sameerwork826/jyoti-thesis/figures/pcb_3d.png

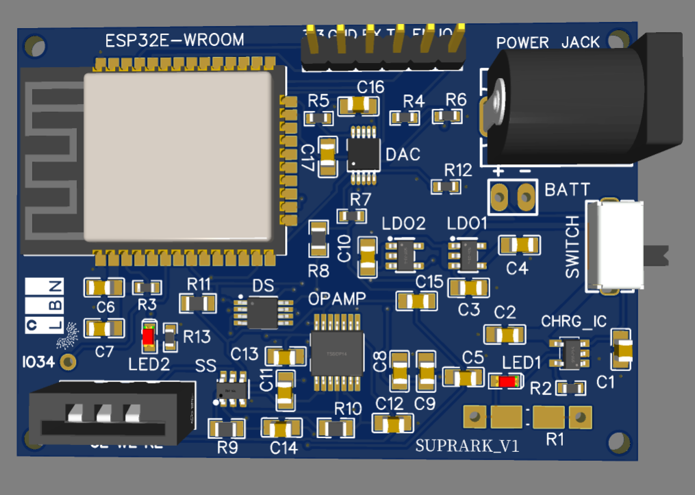
figures/pcb_3d.png
