sameerwork826/jyoti-thesis/README.md

"# jyoti-thesis" 
iit bhu thesis template
https://www.overleaf.com/latex/templates/iit-bhu-varanasi-thesis-template/hhbpqgynrbzv
name - Arkya Jyoti Ghosh
roll no - 21014003
department - Biochemical Engineering
prof name - Dr. Pranjal Chandra
project name - Development of a low cost multimodal amperometric device with web-based monitoring interface for molecular sensing // tentative, subject  to change
