sameerwork826/jyoti-thesis/frontmatter/abbreviations.tex

\chapter*{List of Abbreviations}
\addcontentsline{toc}{chapter}{List of Abbreviations}
\thispagestyle{plain}

\begin{longtable}{@{}p{3.5cm}p{10cm}@{}}
\toprule
\textbf{Abbreviation} & \textbf{Full Form} \\
\midrule
\endhead
\bottomrule
\endfoot

ADC    & Analogue-to-Digital Converter \\
AGND   & Analogue Ground \\
API    & Application Programming Interface \\
BOM    & Bill of Materials \\
CA     & Chronoamperometry \\
CE     & Counter Electrode \\
CV     & Cyclic Voltammetry \\
DAC    & Digital-to-Analogue Converter \\
DET    & Direct Electron Transfer \\
DGND   & Digital Ground \\
DPV    & Differential Pulse Voltammetry \\
EIS    & Electrochemical Impedance Spectroscopy \\
ESP32  & Espressif Systems MCU with integrated Wi-Fi and Bluetooth \\
FDM    & Fused Deposition Modelling \\
FTDI   & Future Technology Devices International (USB-to-UART bridge) \\
HTML   & HyperText Markup Language \\
HTTP   & HyperText Transfer Protocol \\
I$^2$C & Inter-Integrated Circuit (serial communication protocol) \\
IoT    & Internet of Things \\
JSON   & JavaScript Object Notation \\
LDO    & Low-Dropout Regulator \\
LiPo   & Lithium Polymer \\
LOD    & Limit of Detection \\
LOQ    & Limit of Quantification \\
MCU    & Microcontroller Unit \\
MSOP   & Mini Small Outline Package \\
OCP    & Open-Circuit Potential \\
PBS    & Phosphate-Buffered Saline \\
PCB    & Printed Circuit Board \\
PLA    & Polylactic Acid \\
POC    & Point-of-Care \\
RE     & Reference Electrode \\
RSD    & Relative Standard Deviation \\
SoC    & System-on-Chip \\
SPE    & Screen-Printed Electrode \\
SPI    & Serial Peripheral Interface \\
SPIFFS & Serial Peripheral Interface Flash File System \\
TIA    & Transimpedance Amplifier \\
TOF    & Time of Flight \\
UART   & Universal Asynchronous Receiver-Transmitter \\
USB    & Universal Serial Bus \\
WE     & Working Electrode \\
Wi-Fi  & Wireless Fidelity (IEEE 802.11) \\
WS     & WebSocket \\

\end{longtable}
