sameerwork826/jyoti-thesis/frontmatter/certificate.tex

\chapter*{Certificate}
\addcontentsline{toc}{chapter}{Certificate}
\thispagestyle{plain}

\begin{center}
{\large \textbf{INDIAN INSTITUTE OF TECHNOLOGY (BHU), VARANASI}}\\[0.2cm]
{\normalsize School of Biochemical Engineering}\\[1.0cm]
{\Large \textbf{CERTIFICATE}}
\end{center}

\vspace{0.8cm}

This is to certify that the thesis entitled \textbf{``Development of a Low-Cost Multimodal Amperometric Device with Web-Based Monitoring Interface for Molecular Sensing''} submitted by \textbf{Arkya Jyoti Ghosh} (Roll No.\ 21014003) to the Indian Institute of Technology (BHU), Varanasi, is a record of original research work carried out by him under my supervision and guidance in partial fulfillment of the requirements for the award of the degree of \textbf{Bachelor of Technology and Master of Technology (Dual Degree)} in \textbf{Biochemical Engineering}.

\vspace{0.5cm}

To the best of my knowledge, the matter embodied in this thesis has not been submitted to any other university or institute for the award of any degree or diploma.

\vspace{2.5cm}

\noindent
\begin{minipage}[t]{0.45\textwidth}
\textbf{Arkya Jyoti Ghosh}\\
Roll No.\ 21014003\\
B.Tech.--M.Tech.\ (Dual Degree)\\
School of Biochemical Engineering\\
IIT (BHU), Varanasi
\end{minipage}
\hfill
\begin{minipage}[t]{0.45\textwidth}
\textbf{Dr.\ Pranjal Chandra}\\
Professor\\
School of Biochemical Engineering\\
IIT (BHU), Varanasi\\[1.0cm]
Date: \underline{\hspace{4cm}}
\end{minipage}

\vspace{2.0cm}

\noindent
\textbf{Head of Department / Chairman, DPGC}\\
School of Biochemical Engineering\\
IIT (BHU), Varanasi
