sameerwork826/jyoti-thesis/frontmatter/declaration.tex

\chapter*{Declaration}
\addcontentsline{toc}{chapter}{Declaration}
\thispagestyle{plain}

\begin{center}
{\Large \textbf{DECLARATION}}
\end{center}

\vspace{0.8cm}

I, \textbf{Arkya Jyoti Ghosh} (Roll No.\ 21014003), a student of B.Tech.--M.Tech.\ Dual Degree Programme in Biochemical Engineering at the Indian Institute of Technology (BHU), Varanasi, hereby declare that all the information furnished in this thesis, entitled \textbf{``Development of a Low-Cost Multimodal Amperometric Device with Web-Based Monitoring Interface for Molecular Sensing''}, is based on my own research work carried out under the supervision of \textbf{Dr.\ Pranjal Chandra}, Professor, School of Biochemical Engineering, IIT (BHU), Varanasi.

\vspace{0.5cm}

I declare that:
\begin{enumerate}
    \item The thesis comprises only my original research work except where indicated.
    \item Due acknowledgement has been made in the text to all other material used.
    \item The thesis has not been submitted elsewhere for a degree or any other qualification.
\end{enumerate}

\vspace{2.5cm}

\noindent
\begin{minipage}[t]{0.45\textwidth}
Place: Varanasi\\[0.2cm]
Date: \underline{\hspace{4cm}}
\end{minipage}
\hfill
\begin{minipage}[t]{0.45\textwidth}
\textbf{Arkya Jyoti Ghosh}\\
Roll No.\ 21014003\\
B.Tech.--M.Tech.\ Dual Degree\\
School of Biochemical Engineering\\
IIT (BHU), Varanasi
\end{minipage}
