sameerwork826/jyoti-thesis/frontmatter/title.tex

\begin{titlepage}
\begin{center}

\vspace*{0.2cm}

\\[0.45cm]

{\Large \textbf{\institute}}\\[0.2cm]
{\large \textbf{\institutecity}}\\[0.8cm]

{\large \textbf{A Thesis}}\\[0.2cm]
{\normalsize submitted in partial fulfillment of the requirements for the award of the degree of}\\[0.35cm]
{\Large \textbf{\degree}}\\[0.3cm]
{\normalsize in}\\[0.2cm]
{\Large \textbf{\program}}\\[0.75cm]

{\LARGE \textbf{\thetitle}}

\vspace{1.0cm}

{\normalsize Submitted by}\\[0.3cm]
{\Large \textbf{\theauthor}}\\[0.2cm]
{\large Roll No.\ \rollno}

\vspace{0.9cm}

{\normalsize Under the supervision of}\\[0.3cm]
{\Large \textbf{\supervisor}}\\[0.25cm]
{\large \supervisoraffiliation}

\vfill

\textbf{\department}\\
\textbf{\institutewithaddress}\\[0.35cm]
\textbf{\projectstart{} -- \projectend}

\end{center}
\end{titlepage}
