sameerwork826/jyoti-thesis/content/Graphs.pdf

### Thesis Experiments

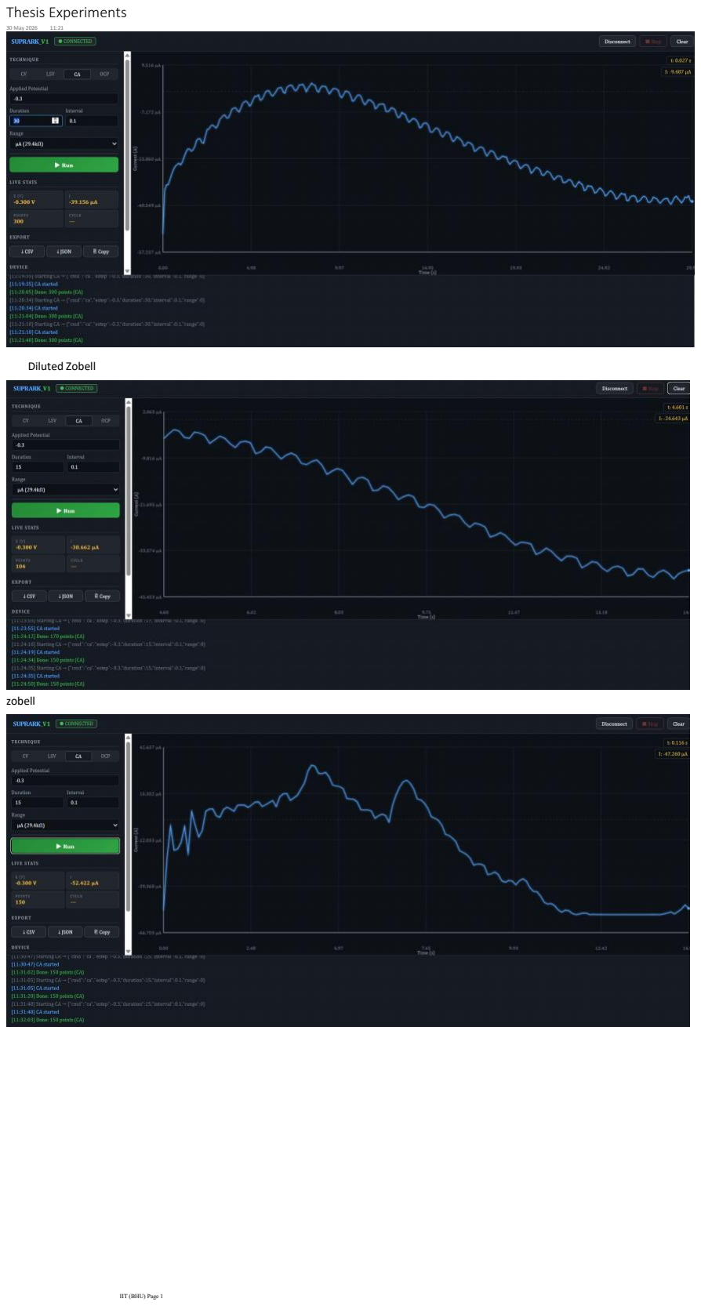
[picture p2: page 1]

Diluted Zobell

zobell

30 May 2026 11:21

IIT (BHU) Page 1

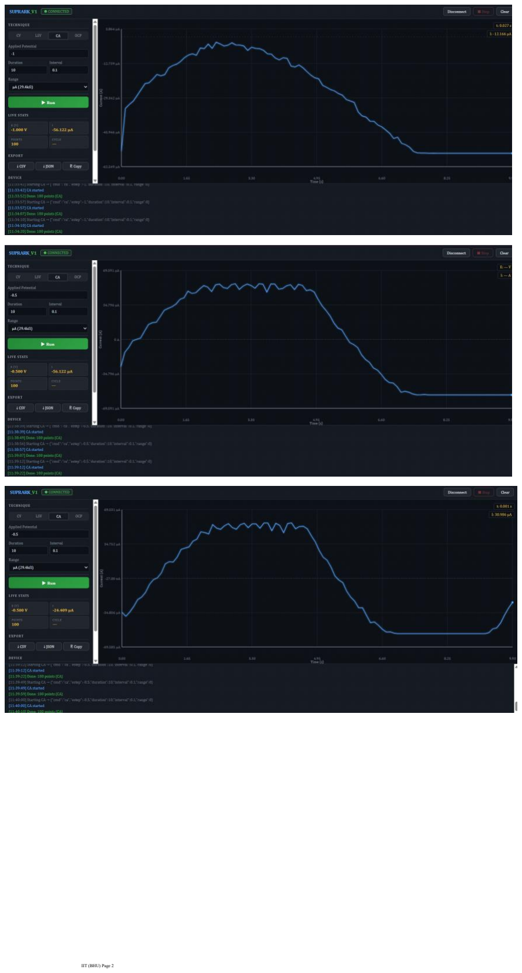
[picture p3: page 2]
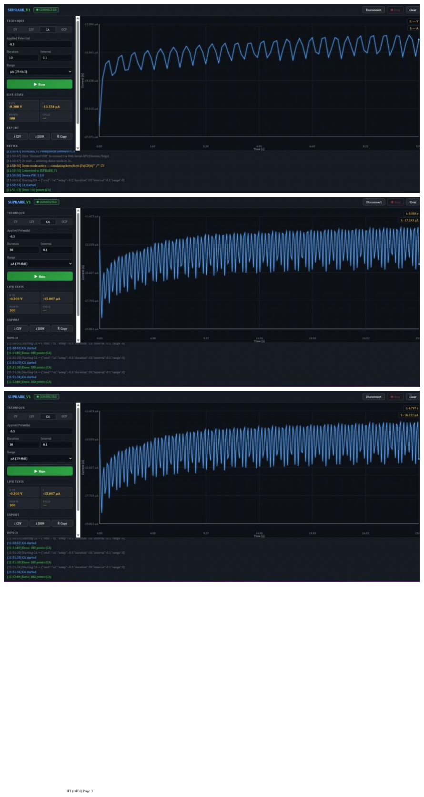
[picture p4: page 3]
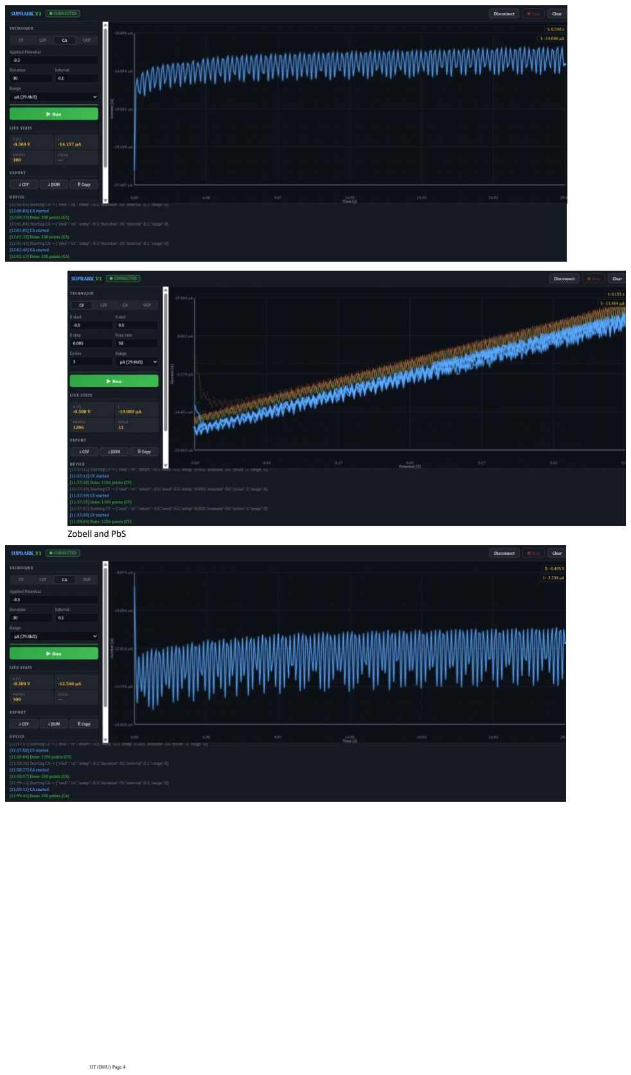
[picture p5: page 4]

Zobell and PbS

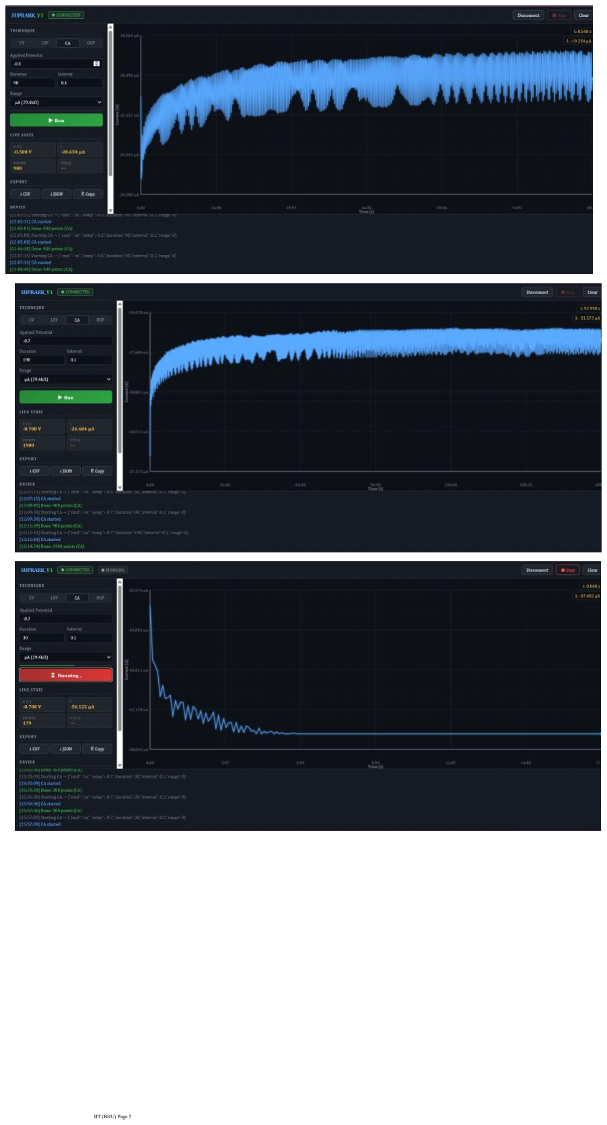
[picture p6: page 5]
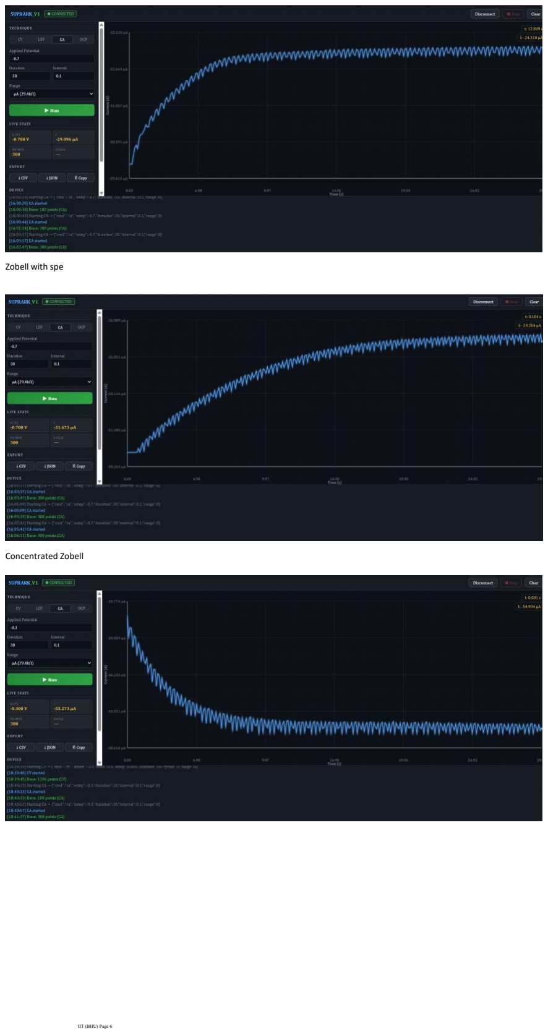
[picture p7: page 6]

Zobell with spe

Concentrated Zobell

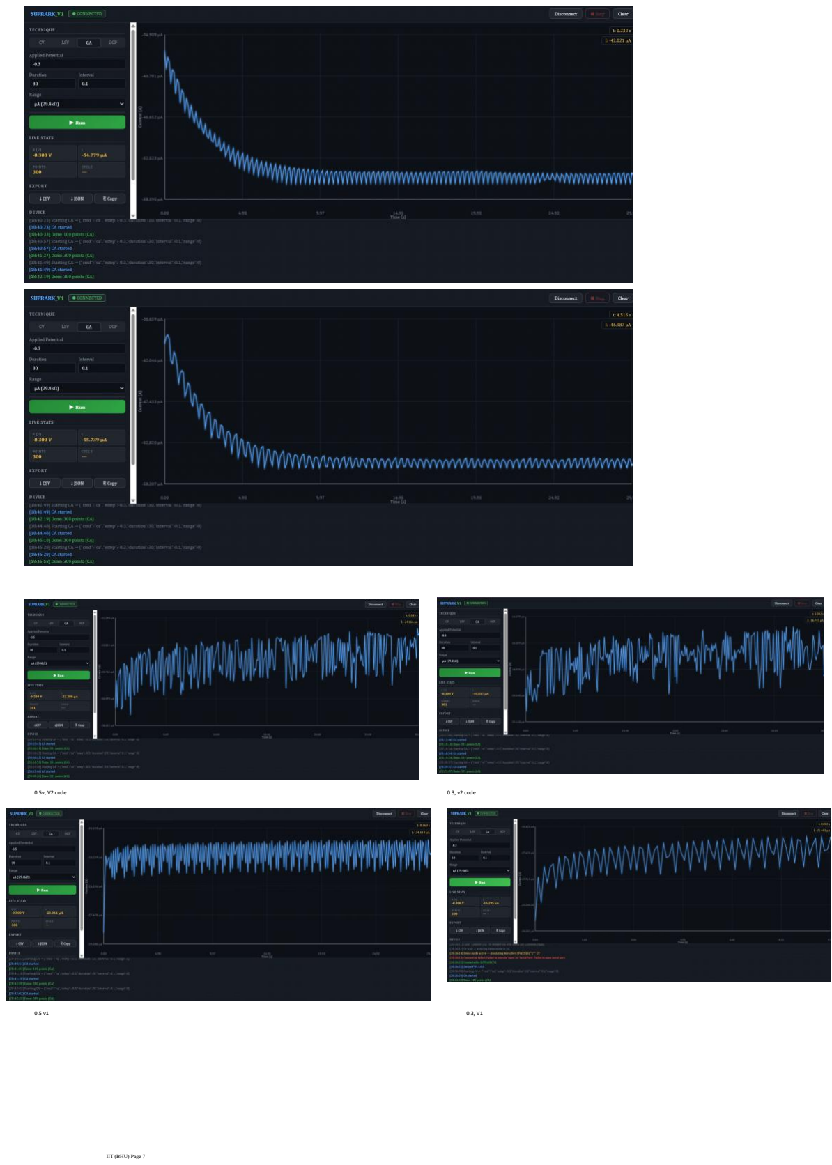
[picture p8: page 7]

0.5v, V2 code | 0.3, v2 code
0.5 v1 | 0.3, V1

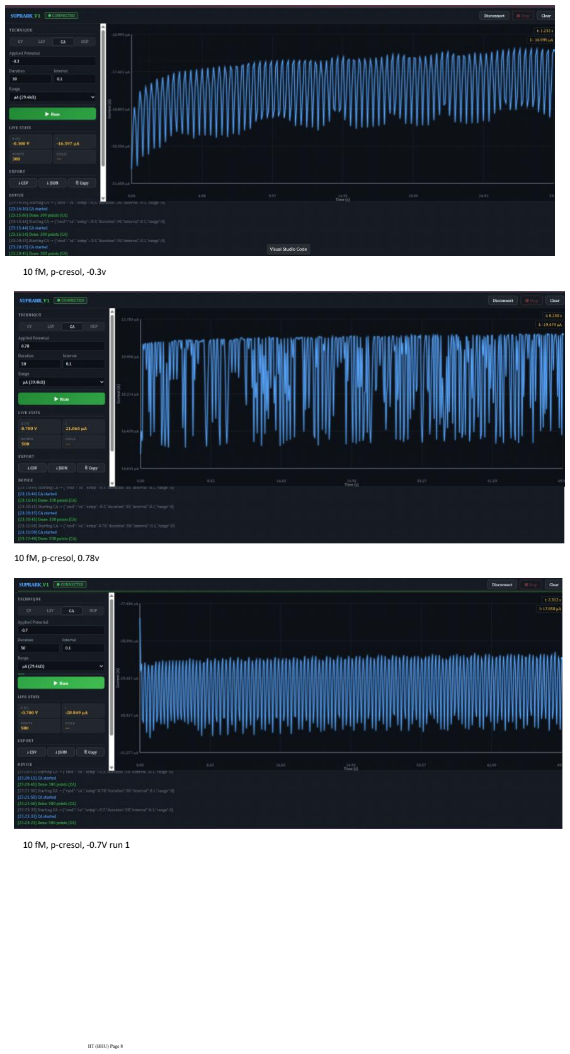
[picture p9: page 8]

10 fM, p-cresol, -0.3v

10 fM, p-cresol, 0.78v

10 fM, p-cresol, -0.7V run 1

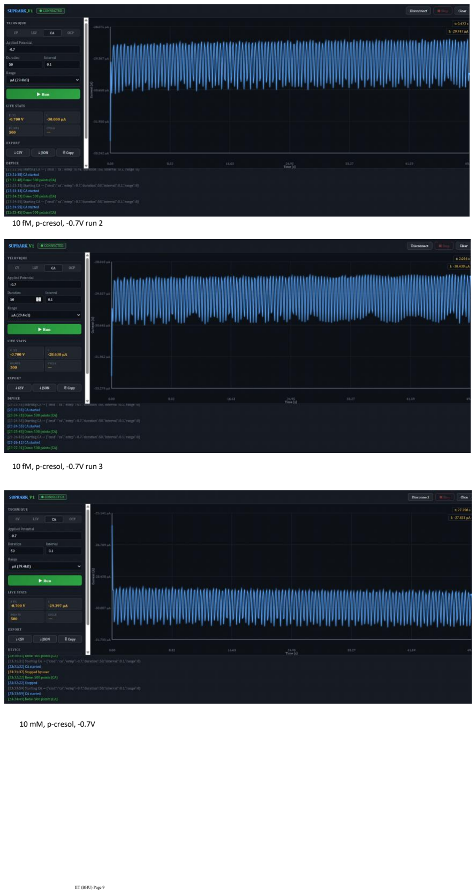
[picture p10: page 9]

10 fM, p-cresol, -0.7V run 2

10 fM, p-cresol, -0.7V run 3

10 mM, p-cresol, -0.7V

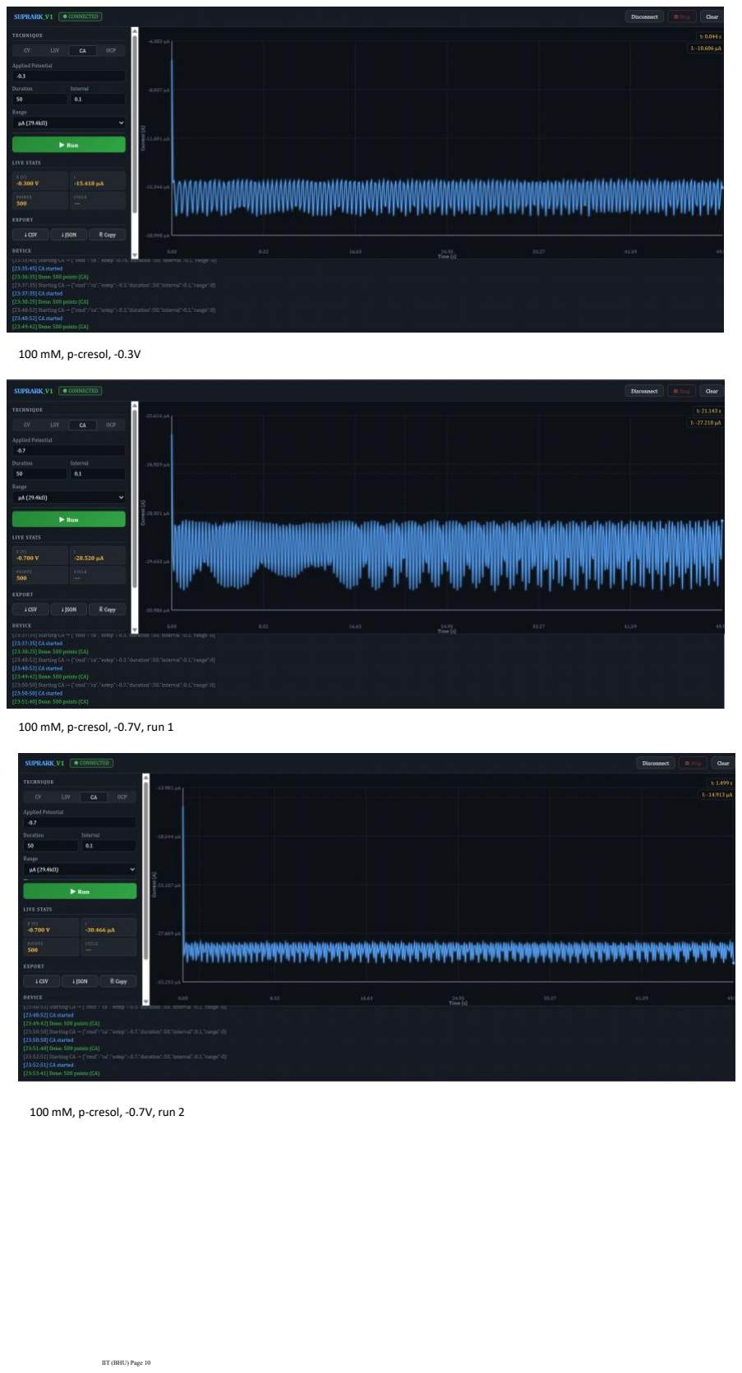
[picture p11: page 10]

100 mM, p-cresol, -0.3V

100 mM, p-cresol, -0.7V, run 1

100 mM, p-cresol, -0.7V, run 2

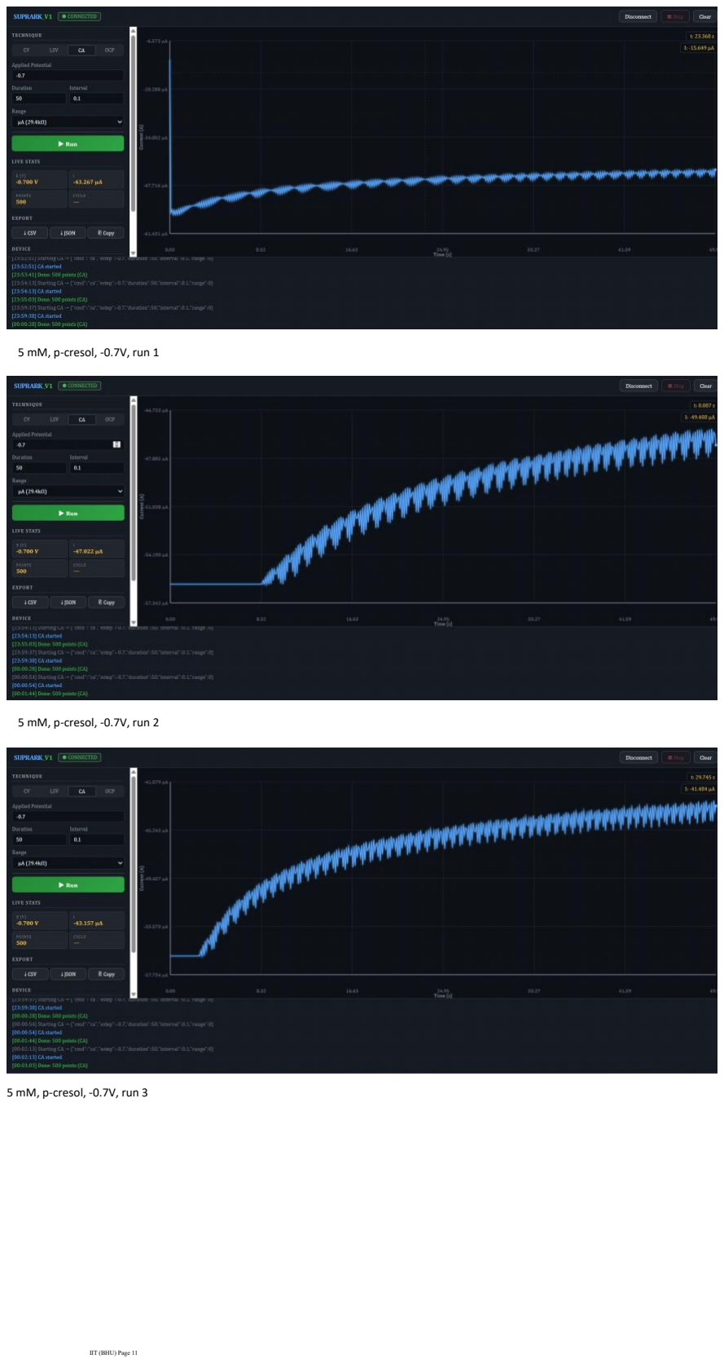
[picture p12: page 11]

5 mM, p-cresol, -0.7V, run 1

5 mM, p-cresol, -0.7V, run 2

5 mM, p-cresol, -0.7V, run 3

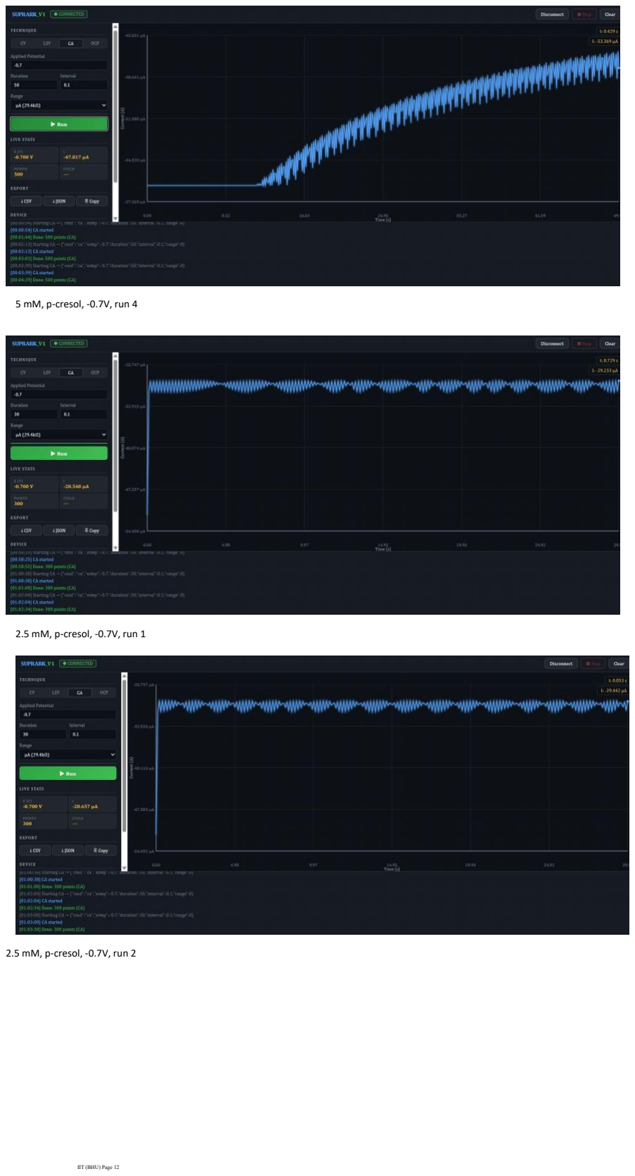
[picture p13: page 12]

5 mM, p-cresol, -0.7V, run 4

2.5 mM, p-cresol, -0.7V, run 1

2.5 mM, p-cresol, -0.7V, run 2

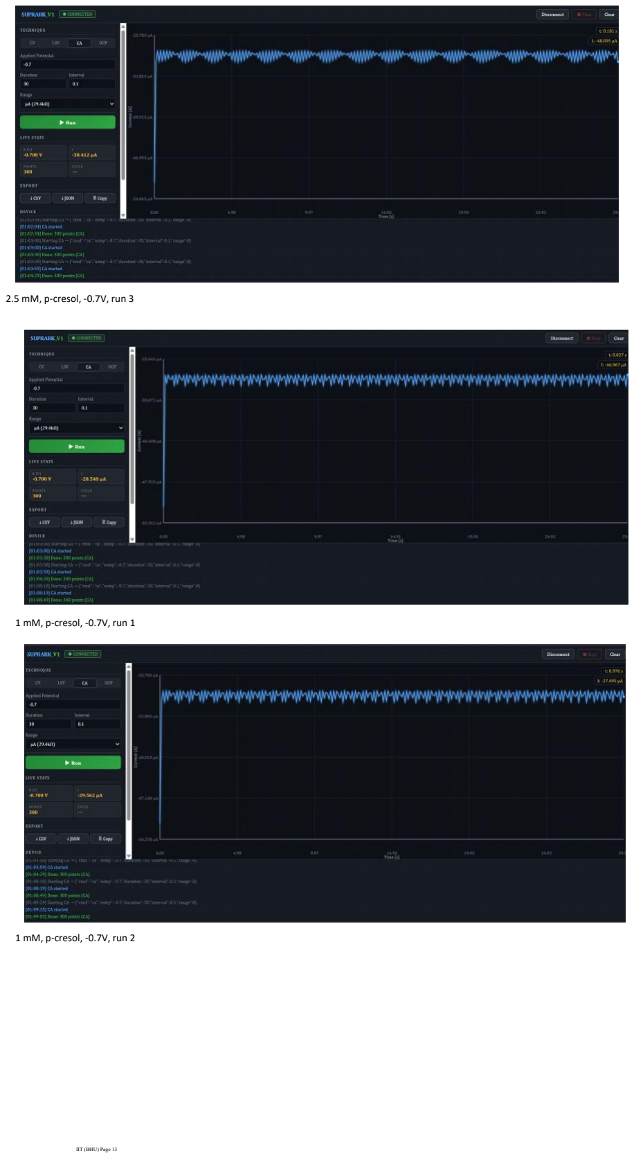
[picture p14: page 13]

2.5 mM, p-cresol, -0.7V, run 3

1 mM, p-cresol, -0.7V, run 1

1 mM, p-cresol, -0.7V, run 2

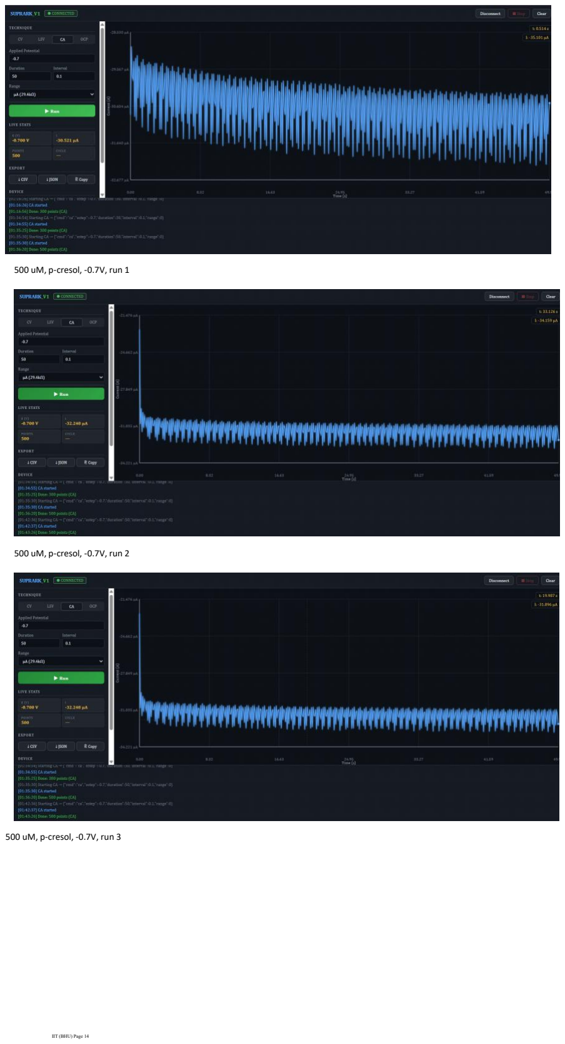
[picture p15: page 14]

500 uM, p-cresol, -0.7V, run 1

500 uM, p-cresol, -0.7V, run 2

500 uM, p-cresol, -0.7V, run 3

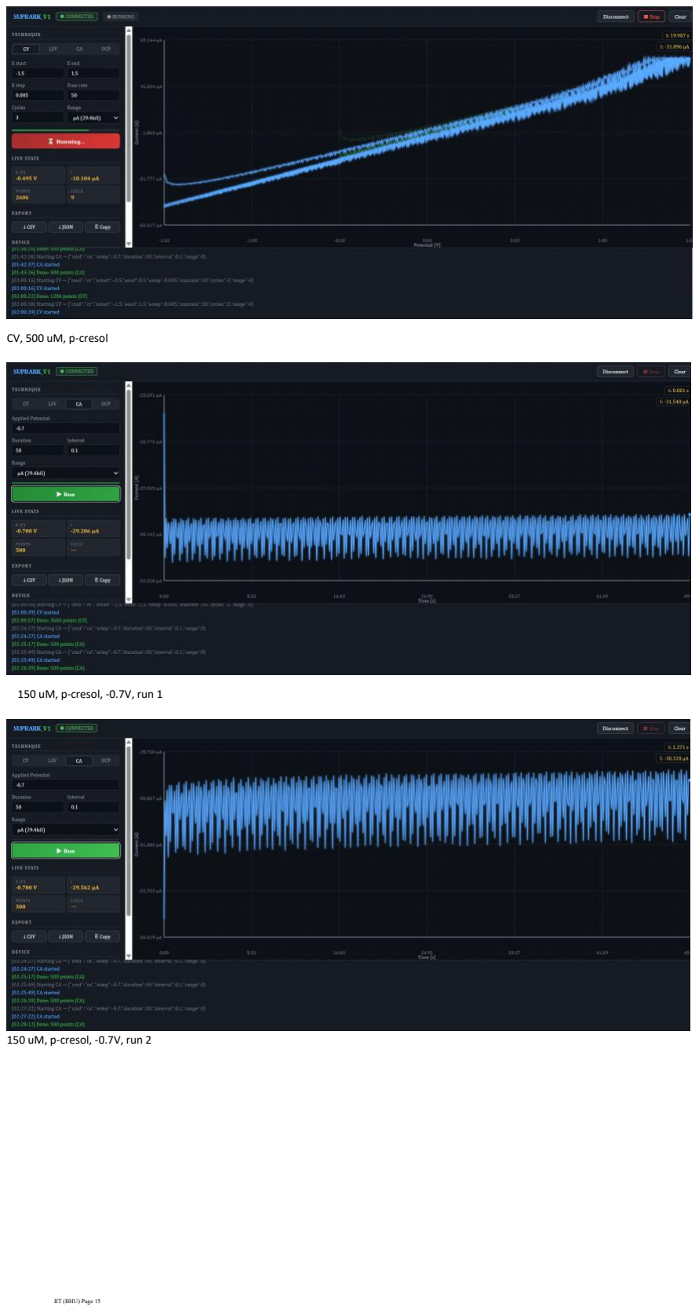
[picture p16: page 15]

CV, 500 uM, p-cresol

150 uM, p-cresol, -0.7V, run 1

150 uM, p-cresol, -0.7V, run 2

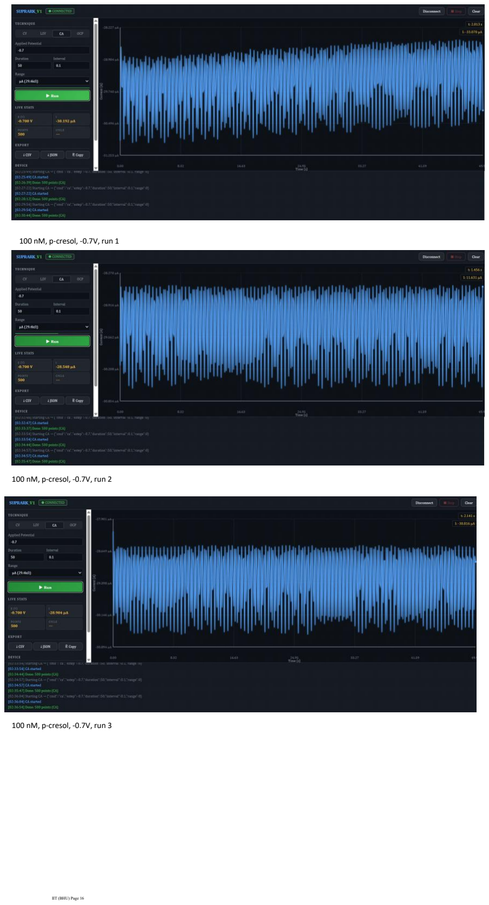
[picture p17: page 16]

100 nM, p-cresol, -0.7V, run 1

100 nM, p-cresol, -0.7V, run 2

100 nM, p-cresol, -0.7V, run 3

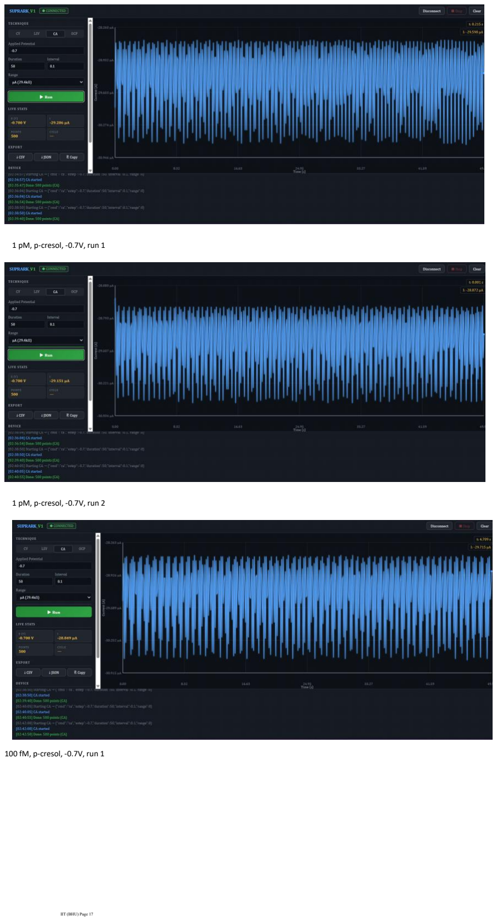
[picture p18: page 17]

1 pM, p-cresol, -0.7V, run 1

1 pM, p-cresol, -0.7V, run 2

100 fM, p-cresol, -0.7V, run 1

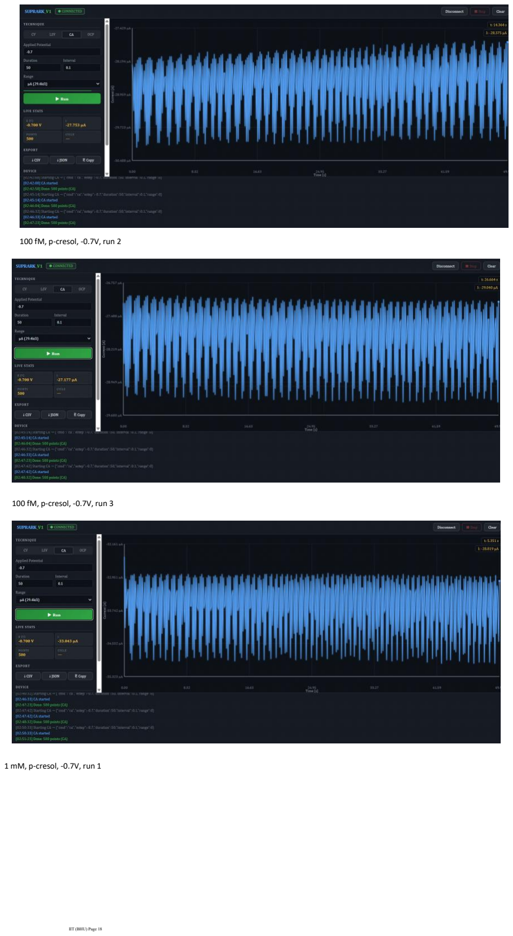
[picture p19: page 18]

100 fM, p-cresol, -0.7V, run 2

100 fM, p-cresol, -0.7V, run 3

1 mM, p-cresol, -0.7V, run 1

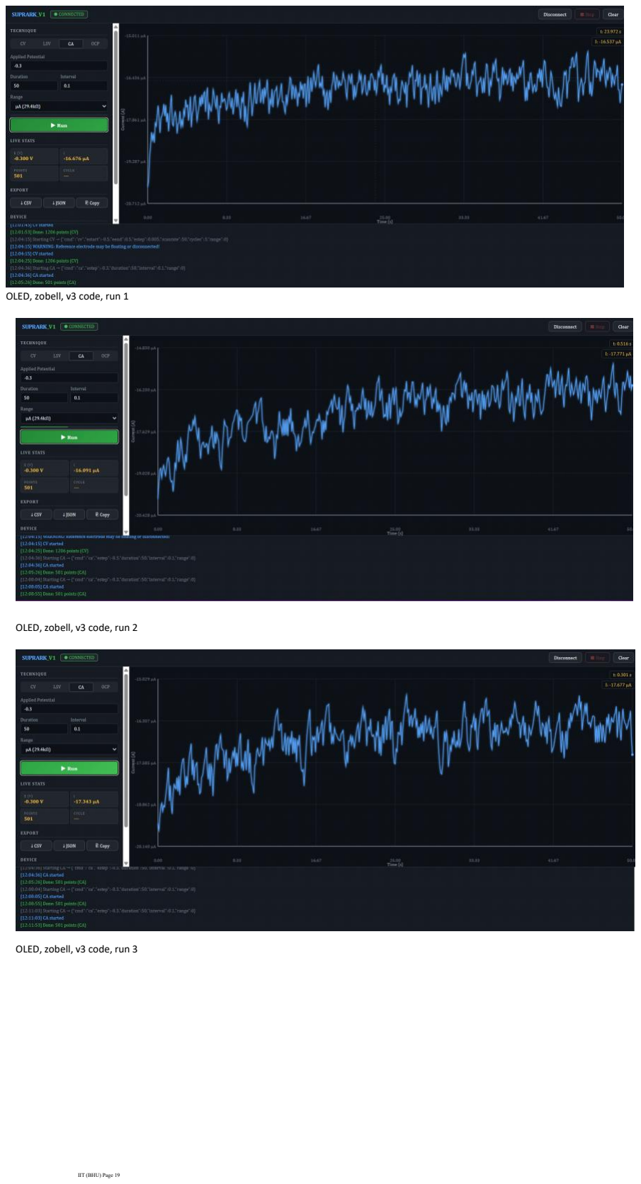
[picture p20: page 19]

OLED, zobell, v3 code, run 1

OLED, zobell, v3 code, run 2

OLED, zobell, v3 code, run 3

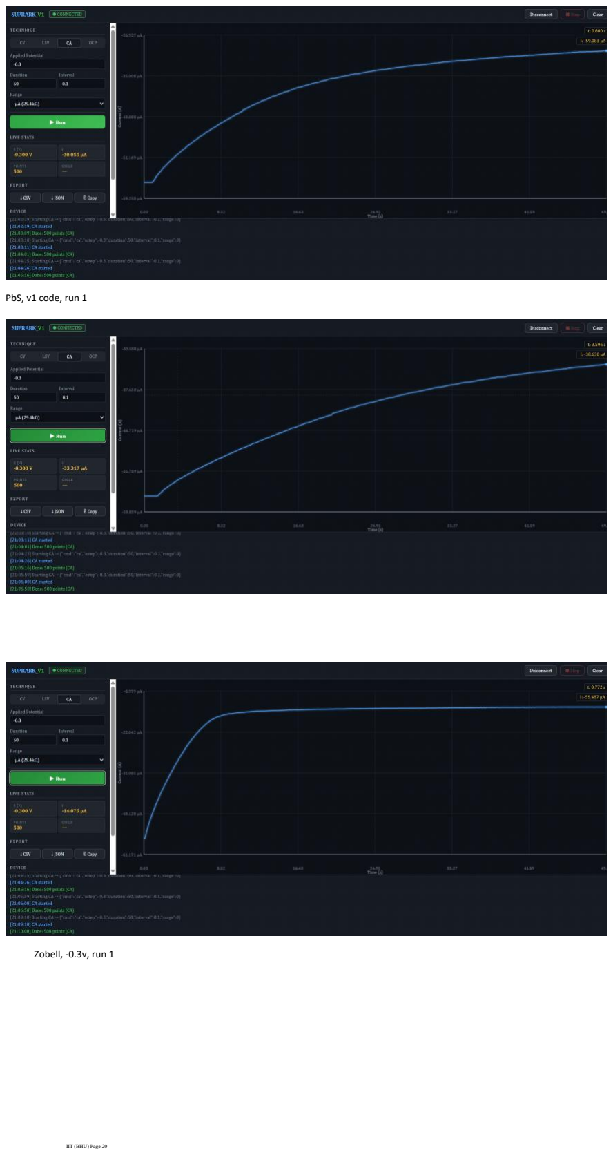
[picture p21: page 20]

PbS, v1 code, run 1

Zobell, -0.3v, run 1

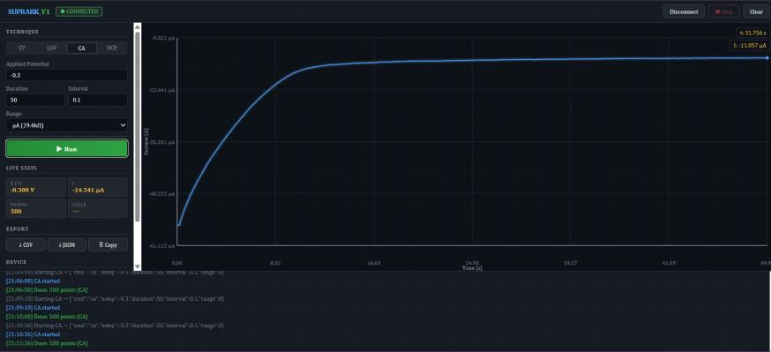
[picture p22: figure]

Zobell, -0.3v, run 1, stabilizng at exactly same voltage, craxxxyyyyyy
