sameerwork826/jyoti-thesis/content/Patent.md

Please fill out this IITBHU patent application form for me, copy the same format as in the docx file, and instead of the thermal imaging system, this patent is for the amperometric device that we have developed for molecular sensing.You can use the same title or think of something new, now that you know what we have used it for and how, what it is etc. So fill all the sections accordingly, keep the names of the inventors and everythig the same, use today's dates, fill it up nicely.

follow these instruction and fill new patent intial draft docx for me
