sameerwork826/jyoti-thesis/frontmatter/acknowledgements.tex

\chapter*{Acknowledgements}
\addcontentsline{toc}{chapter}{Acknowledgements}
\thispagestyle{plain}

I would like to express my sincere gratitude to all those who have contributed to the successful completion of this thesis.

First and foremost, I am deeply indebted to my thesis supervisor, \textbf{Dr.\ Pranjal Chandra}, Professor, School of Biochemical Engineering, IIT (BHU), Varanasi, for his invaluable guidance, constant encouragement, and intellectual support throughout the course of this research. His vision for innovative biosensing and his insistence on rigorous scientific methodology have profoundly shaped this work. I am grateful for his patience in allowing me to explore the intersection of hardware engineering and biochemistry, and for providing the freedom to prototype and iterate rapidly.

I am thankful to the \textbf{School of Biochemical Engineering, IIT (BHU), Varanasi}, and its faculty members for providing the necessary academic and laboratory facilities. I also thank the \textbf{Head of the Department} and the \textbf{Chairman, DPGC}, for their administrative support.

I owe special thanks to my fellow lab members for their support, stimulating discussions, and assistance during the experimental phases of this project. Their camaraderie made long hours in the laboratory enjoyable and productive.

I extend my appreciation to \textbf{JLCPCB} for prompt and high-quality PCB fabrication, and to the open-source communities behind the ESP32 Arduino ecosystem, EasyEDA, PlatformIO, and the various libraries employed in the firmware and web application.

I am profoundly grateful to my \textbf{parents and family} for their unconditional love, constant encouragement, and unwavering faith in me throughout my academic journey. Without their support, this work would not have been possible.

Finally, I acknowledge the financial support provided by \textbf{IIT (BHU), Varanasi} through its research and academic facilities.

\vspace{1.5cm}
\noindent\hfill \textbf{Arkya Jyoti Ghosh}\\
\hfill Varanasi, 2026
