sameerwork826/jyoti-thesis/content/BOM_Potentiostat-Project_2025-10-22.csv

ID | Name | Designator | Footprint | Quantity | Manufacturer Part | Manufacturer | Supplier | Supplier Part | Price
1 | MIC5205-3.3YM5 | 3.3V_LDO_1,3.3V_LDO_2 | SOT-23-5_L3.0-W1.7-P0.95-LS2.8-TL | 2 | MIC5205-3.3YM5-TR | MICROCHIP(美国微芯) | LCSC | C37970 | 0.365
2 | Batt | BT1 | BAT-TH_2P-9VBATTERY | 1 | 9V电池铜线扣 铜100mm | Q&J | LCSC | C70374 | 0.103
3 | 4.7uF | C1,C2 | C0805 | 2 | TCC0805X5R475M500FT | CCTC(三环) | LCSC | C7393930 | 0.016
4 | 10uF | C3,C6,C9,C10,C17 | C0805 | 5 | GRT21BC71E106KE13L | muRata(村田) | LCSC | C882505 | 0.115
5 | 470pF | C4,C5 | C0805 | 2 | GCM21A7U2E471JX01D | muRata(村田) | LCSC | C417152 | 0.06
6 | 100nF | C7,C8,C11,C14,C15,C16 | C0805 | 6 | CC0805JRX7R7BB104 | YAGEO(国巨) | LCSC | C520082 | 0.008
7 | 10nF | C12,C13 | C0805 | 2 | CGA0805X7R103K101KT | HRE(芯声) | LCSC | C7503490 | 0.005
8 | AD5667RBRMZ-2REEL7 | DAC | MSOP-10_L3.0-W3.0-P0.50-LS4.9-BL | 1 | AD5667RBRMZ-2REEL7 | ADI(亚德诺) | LCSC | C650006 | 15.353
9 | MAX4643EUA+ | DUAL_SWITCH | UMAX-8_L3.0-W3.0-P0.65-LS4.9-BL | 1 | MAX4643EUA+ | ADI(亚德诺)/MAXIM(美信) | LCSC | C1546042 | 4.384
10 | HDR-M-2.54_1x1 | J1,J2,J3,J4,J5,J6 | HDR-M-2.54_1X1 | 6 |  |  | LCSC | C81276 | 0.007
11 | LED-0603_R | LED1,LED2 | LED0603_RED | 2 | 19-217/R6C-AL1M2VY/3T | EVERLIGHT(台湾亿光) | LCSC | C72044 | 0.021
12 | 470E | R1 | RESISTOR_SMD+THTUNIVERSAL_0805TO1206_RM10_HANDSOLDERING_REVA_DATE25JUN2010 | 1 | RN1WS470ΩFT/BA1 | Tyohm(幸亚电阻) | LCSC | C385392 | 0.02
13 | 2K | R2 | R0603 | 1 | RMS06JT202 | 大毅科技 | LCSC | C209226 | 0.003
14 | 10k | R3,R4,R5,R6,R12 | R0603 | 5 | TC0325D1002T5F | UNI-ROYAL(厚声) | LCSC | C2989345 | 0.01
15 | 1.2k | R7 | R0603 | 1 | ARG03BTC1201 | Viking(光颉) | LCSC | C2984430 | 0.023
16 | 16.2k | R8 | R0805 | 1 | AC0805FR-0716K2L | YAGEO(国巨) | LCSC | C228332 | 0.005
17 | 845 | R9 | R0805 | 1 | ARG05FTC8450N | Viking(光颉) | LCSC | C218710 | 0.008
18 | 29.4k | R10 | R0805 | 1 | AC0805FR-0729K4L | YAGEO(国巨) | LCSC | C228690 | 0.004
19 | 8.06k | R11 | R0805 | 1 | 0805W8F8061T5E | UNI-ROYAL(厚声) | LCSC | C19006 | 0.002
20 | 220 | R13 | R0603 | 1 | AC0603FR-07220RL | YAGEO(国巨) | LCSC | C138284 | 0.002
21 | TPMAX4644EUT+T | SINGLE_SWITCH | SOT-23-6_L2.9-W1.6-P0.95-LS2.9-BL | 1 | TPMAX4644EUT+T | TECH PUBLIC(台舟) | LCSC | C42449032 | 0.335
22 | DS1020-03ST1D_C40878053 | SPE_CONNECTOR | CONN-TH_3P-P2.54_DS1020-03ST1D | 1 | DS1020-03ST1D | null | LCSC | C40878053
23 | SK-12D02-VG5 | SW1 | SW-TH_SK-12D02VG3 | 1 | SK-12D02-VG5 | Rectangular Connectors - Contacts | LCSC | C136722 | 0.074
24 | POWER-JACK | U1 | DC-IN-TH_POWER-JACK | 1 | POWER-JACK | 索峰 | LCSC | C9900001795
25 | MCP73831T-2ATI/OT | U3 | SOT-23-5_L3.0-W1.7-P0.95-LS2.8-BR | 1 | MCP73831T-2ATI/OT | MICROCHIP(美国微芯) | LCSC | C14879 | 1.701
26 | ESP32-WROOM-32E(4MB) | U6 | WIFI-SMD_ESP32-WROOM-32E | 1 | ESP32-WROOM-32E-N4 | ESPRESSIF(乐鑫) | LCSC | C701341 | 3.85
27 | AD8608ARUZ | U11 | TSSOP-14_L5.0-W4.4-P0.65-LS6.4-BL | 1 | AD8608ARUZ | ADI(亚德诺) | LCSC | C578776 | 4.17
