sameerwork826/jyoti-thesis/content/Bottom.stl

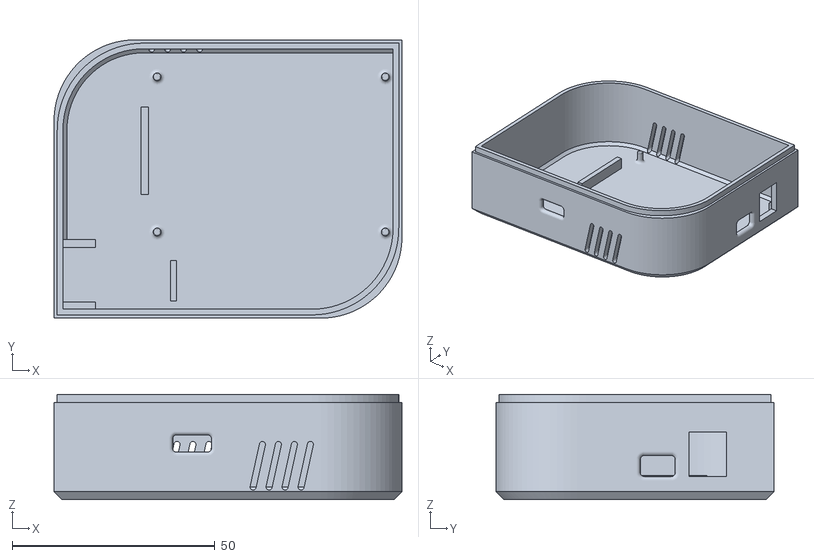
[picture p23: CAD file, 2026-06-01]
content/Bottom.stl
85.8 x 68.6 x 26.0
