sameerwork826/jyoti-thesis/content/Top.stl

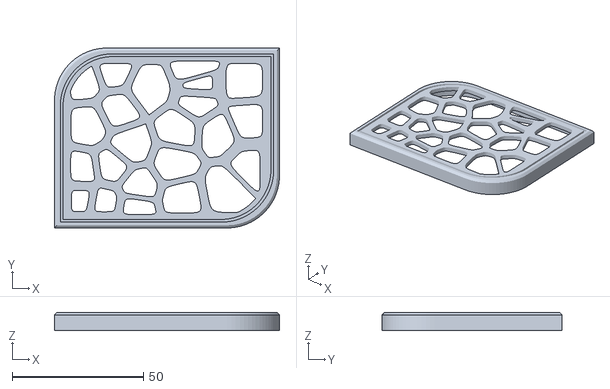
[picture p24: CAD file, 2026-06-01]
content/Top.stl
85.8 x 68.6 x 7.00
