sameerwork826/jyoti-thesis/content/Schematic_Potentiostat-Project_2026-05-29.pdf

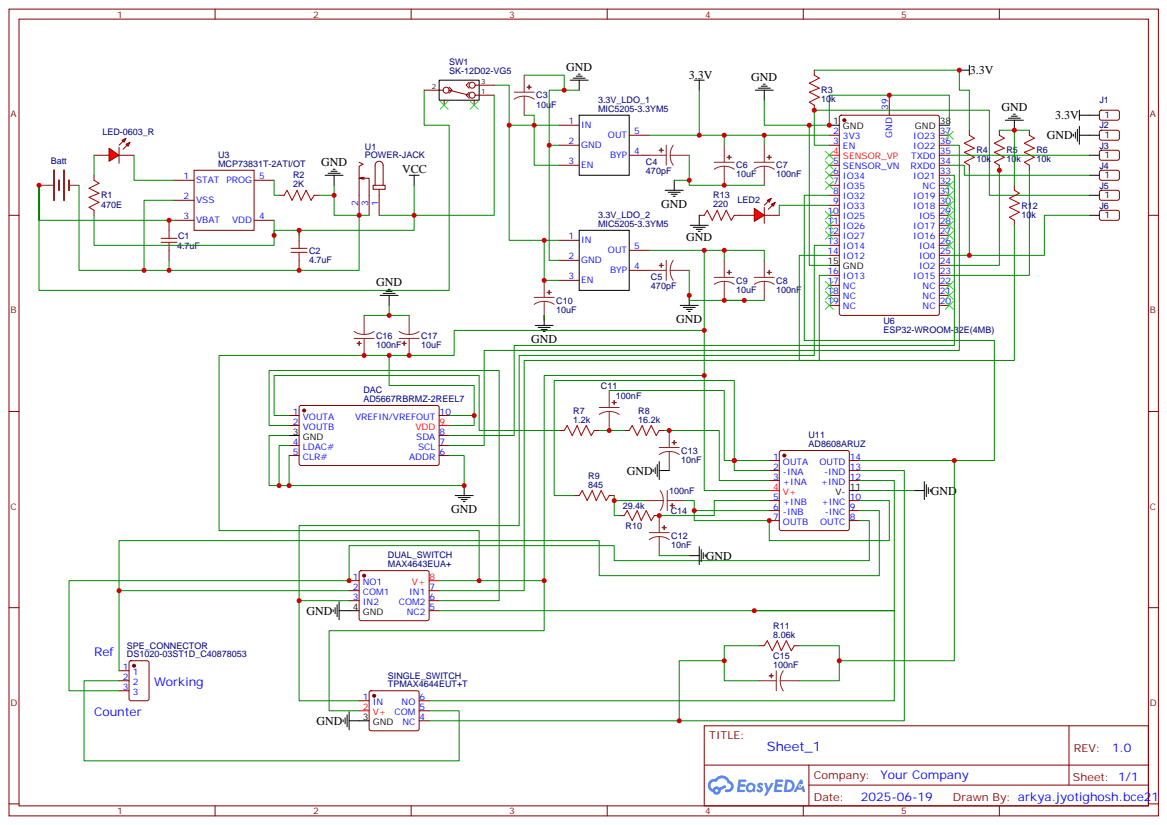
[picture p25: page 1]

Drawn By: arkya.jyotighosh.bce21
