sameerwork826/jyoti-thesis/(commit log)

2026-06-01 feat: complete IIT BHU dual degree thesis scaffold in LaTeX
    - main.tex + preamble.tex with IIT BHU formatting (Times font, 1.5 spacing, binding margins)
    - frontmatter: title page, certificate, declaration, abstract, acknowledgements, abbreviations
    - Chapter 1: Introduction (background, analytes, objectives, scope)
    - Chapter 2: Literature Review (CA theory, open-source potentiostats, p-cresol, H2O2, redox probes)
    - Chapter 3: Materials and Methods (hardware, firmware, web UI, 3D enclosure, protocols)
    - Chapter 4: Results and Discussion (device validation, Cottrell analysis, calibration curves, cost)
    - Chapter 5: Conclusion and Future Work
    - Appendix A: Full BOM table and PCB specifications
    -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
    [BOM_Potentiostat-Project_2025-10-22.csv, Bottom.stl, Top.stl]
2026-06-01 feat: integrate SUPRANK_V1 identity and real PCB image
    - Added PCB_3D.png (actual board render) to figures/ and wired into Chapter 3
    - Named the device SUPRANK_V1 throughout (abstract, Ch1 objectives, Ch3, Ch4)
    - Updated \graphicspath to cover both figures/ and content/ directories
